fedelt01hub/honda-civic-scanner/hardware/fab/render-bottom.png

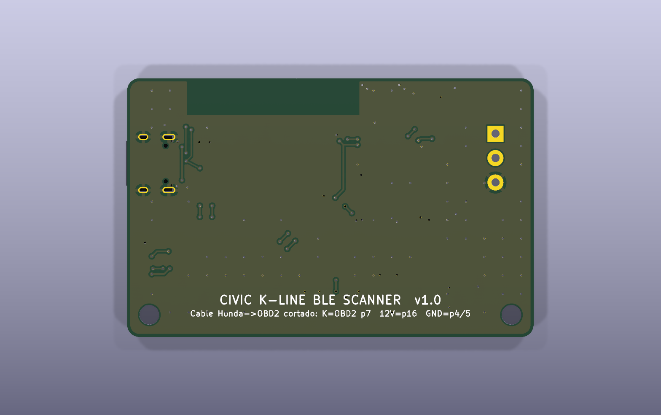
hardware/fab/render-bottom.png
