fedelt01hub/honda-civic-scanner/hardware/fab/render-top.png

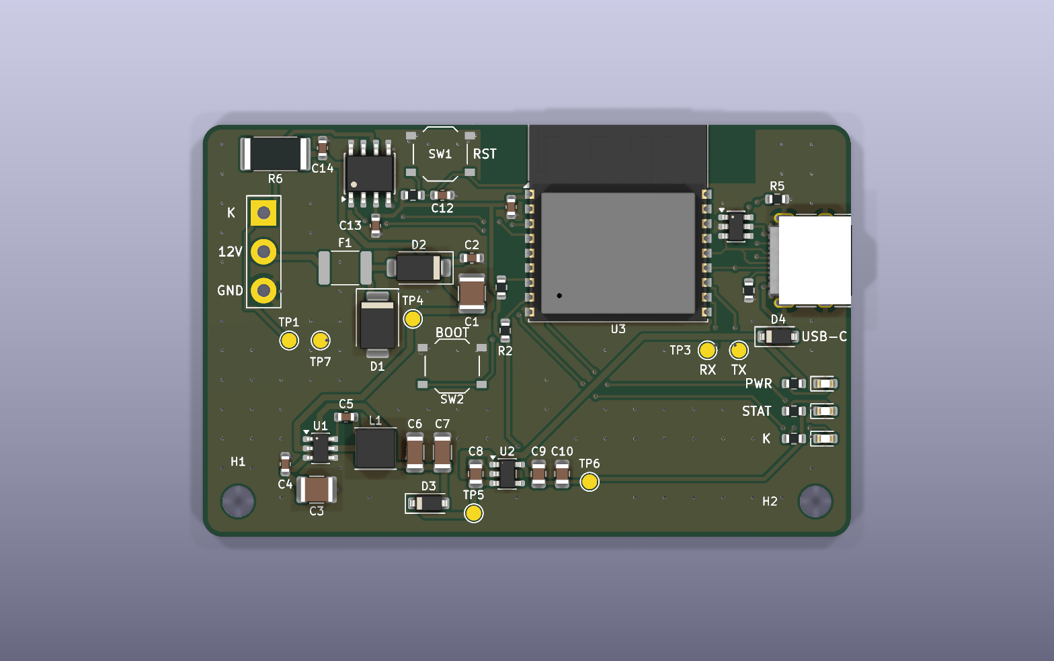
hardware/fab/render-top.png
