fedelt01hub/honda-civic-scanner/hardware/fab/civic_scanner-bom-jlcpcb.csv

Comment | Designator | Footprint | LCSC | Qty | MPN | Manufacturer
10uF 50V | C1,C3 | C_1210_3225Metric | C77102 | 2 | GRM32ER71H106KA12L | Murata
100nF 50V | C2,C4,C14 | C_0603_1608Metric | C14663 | 3 | CC0603KRX7R9BB104 | YAGEO
100nF | C5,C11,C13 | C_0603_1608Metric | C14663 | 3 | CC0603KRX7R9BB104 | YAGEO
22uF 25V | C6,C7 | C_1206_3216Metric | C12891 | 2 | CL31A226KAHNNNE | Samsung
10uF | C8,C9 | C_0805_2012Metric | C15850 | 2 | CL21A106KAYNNNE | Samsung
22uF | C10 | C_0805_2012Metric | C45783 | 1 | CL21A226MAQNNNE | Samsung
1uF | C12 | C_0603_1608Metric | C15849 | 1 | CL10A105KB8NNNC | Samsung
SMBJ18A | D1 | D_SMB | C353379 | 1 | SMBJ18A | Jingdao
SS34 | D2 | D_SMA | C8678 | 1 | SS34 | MDD
B5819W | D3,D4 | D_SOD-123 | C8598 | 2 | B5819W SL | Changjiang
PWR | D5 | LED_0603_1608Metric | C2290 | 1 | KT-0603W | Hubei KENTO
STATUS | D6 | LED_0603_1608Metric | C89811 | 1 | NCD0603Y2 | NATIONSTAR
K-LINE | D7 | LED_0603_1608Metric | C2286 | 1 | KT-0603R | Hubei KENTO
mSMD050-60V | F1 | Fuse_1812_4532Metric | C70113 | 1 | mSMD050-60V | Shenzhen JDT
USB-C | J2 | USB_C_Receptacle_HRO_TYPE-C-31-M-12 | C165948 | 1 | TYPE-C-31-M-12 | Korean Hroparts
4.7uH | L1 | L_Changjiang_FNR4030S | C167874 | 1 | FNR4030S4R7MT | Changjiang
10k | R1-R3 | R_0603_1608Metric | C25804 | 3 | 0603WAF1002T5E | UNI-ROYAL
5.1k | R4,R5 | R_0603_1608Metric | C23186 | 2 | 0603WAF5101T5E | UNI-ROYAL
1k 1W | R6 | R_2512_6332Metric | C54315 | 1 | 25121WF1001T4E | UNI-ROYAL
1k | R7-R9 | R_0603_1608Metric | C21190 | 3 | 0603WAF1001T5E | UNI-ROYAL
RESET | SW1 | SW_Push_1P1T_XKB_TS-1187A | C318884 | 1 | TS-1187A-B-A-B | XKB Connection
BOOT | SW2 | SW_Push_1P1T_XKB_TS-1187A | C318884 | 1 | TS-1187A-B-A-B | XKB Connection
AP63205WU-7 | U1 | TSOT-23-6 | C2071056 | 1 | AP63205WU-7 | Diodes Inc
AP2112K-3.3TRG1 | U2 | SOT-23-5 | C51118 | 1 | AP2112K-3.3TRG1 | Diodes Inc
ESP32-C3-WROOM-02-N4 | U3 | ESP32-C3-WROOM-02_JLC | C2934560 | 1 | ESP32-C3-WROOM-02-N4 | Espressif
USBLC6-2SC6 | U4 | SOT-23-6 | C2687116 | 1 | USBLC6-2SC6 | UMW
L9637D | U5 | SOIC-8_3.9x4.9mm_P1.27mm | C153038 | 1 | E-L9637D013TR | STMicroelectronics
