fedelt01hub/honda-civic-scanner/hardware/freecad/case_base_asm.stl

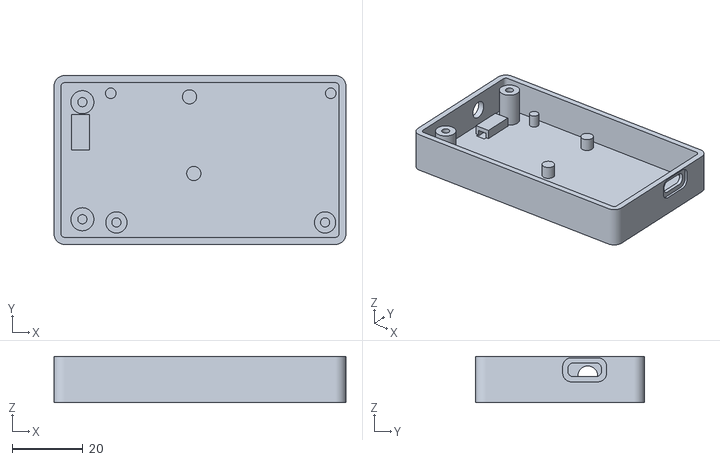
[picture p3: CAD file, 2026-11-05]
hardware/freecad/case_base_asm.stl
82.3 x 47.6 x 13.0
