fedelt01hub/honda-civic-scanner/hardware/enclosure/case_assembly.stl

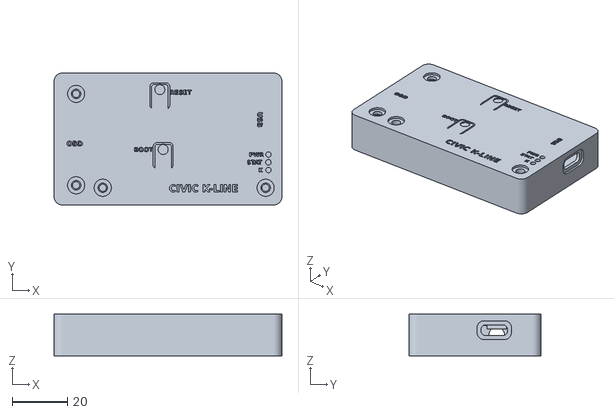
[picture p4: CAD file, 2026-11-05]
hardware/enclosure/case_assembly.stl
82.3 x 47.6 x 15.0
