fedelt01hub/honda-civic-scanner/hardware/freecad/case_lid_asm.stl

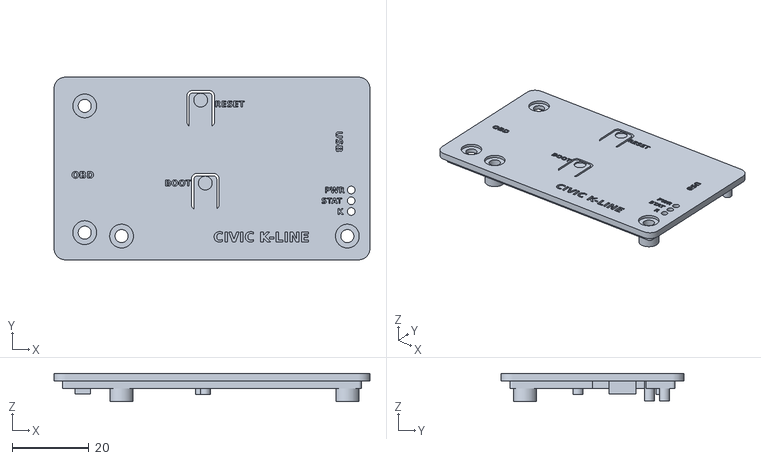
[picture p5: CAD file, 2026-11-05]
hardware/freecad/case_lid_asm.stl
82.3 x 47.6 x 7.35
