fedelt01hub/honda-civic-scanner/hardware/freecad/civic_scanner_ensamble.FCStd

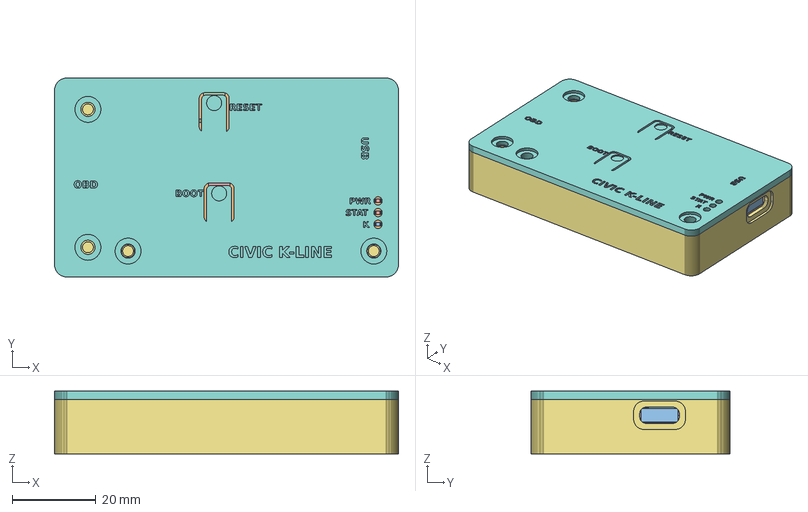
[picture p6: CAD file, 2026-11-05]
hardware/freecad/civic_scanner_ensamble.FCStd
82.3 x 47.6 x 15.0 mm
R_0603_1608Metric
C_0603_1608Metric
R_0603_1608Metric002
SOT-23-5
C_0603_1608Metric002
C_0603_1608Metric004
C_0603_1608Metric006
C_1210_3225Metric
D_SOD-123
R_0603_1608Metric004
LED_0603_1608Metric
ESP32-C3-WROOM-02
ESP32-C3-WROOM-001
ESP32-C3-WROOM-002
ESP32-C3-WROOM-003
ESP32-C3-WROOM-004
ESP32-C3-WROOM-005
ESP32-C3-WROOM-006
ESP32-C3-WROOM-007
ESP32-C3-WROOM-008
ESP32-C3-WROOM-009
ESP32-C3-WROOM-010
ESP32-C3-WROOM-011
ESP32-C3-WROOM-012
ESP32-C3-WROOM-013
ESP32-C3-WROOM-014
ESP32-C3-WROOM-015
ESP32-C3-WROOM-016
ESP32-C3-WROOM-017
ESP32-C3-WROOM-018
ESP32-C3-WROOM-019
ESP32-C3-WROOM-020
ESP32-C3-WROOM-021
ESP32-C3-WROOM-022
ESP32-C3-WROOM-023
ESP32-C3-WROOM-024
ESP32-C3-WROOM-025
ESP32-C3-WROOM-026
ESP32-C3-WROOM-027
ESP32-C3-WROOM-028
ESP32-C3-WROOM-029
SOIC-8_3.9x4.9mm_P1.27mm
R_0603_1608Metric006
C_1206_3216Metric
LED_0603_1608Metric002
R_2512_6332Metric
R_0603_1608Metric008
D_SMA
C_0805_2012Metric
R_0603_1608Metric010
C_0603_1608Metric008
TSOT-23-6
C_1210_3225Metric002
C_0805_2012Metric002
C_0603_1608Metric010
C_0805_2012Metric004
SOT-23-6
R_0603_1608Metric012
C_0603_1608Metric012
D_SOD-125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
