fedelt01hub/honda-civic-scanner/hardware/enclosure/case_preview_exploded.stl

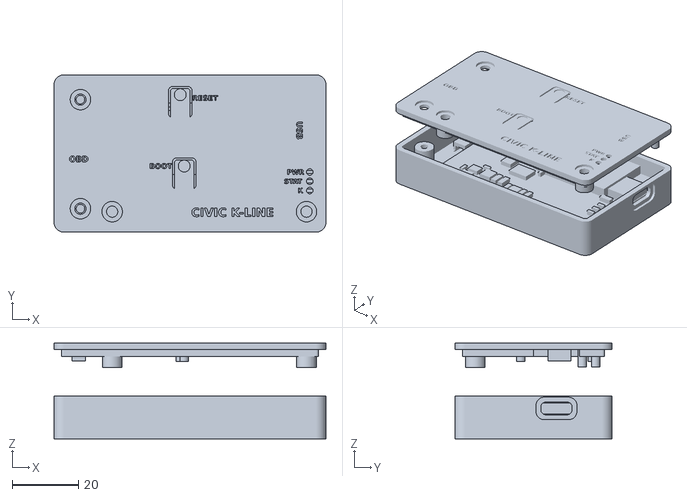
[picture p7: CAD file, 2026-11-05]
hardware/enclosure/case_preview_exploded.stl
82.3 x 47.6 x 29.0
