fedelt01hub/honda-civic-scanner/hardware/freecad/civic_scanner_pcb.step

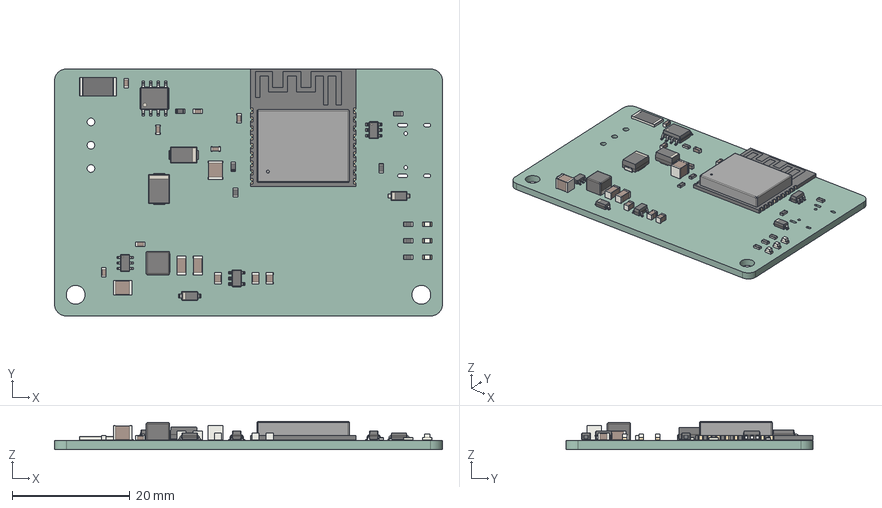
[picture p8: CAD file, 2026-11-05]
hardware/freecad/civic_scanner_pcb.step
66.0 x 42.0 x 4.79 mm
R_0603_1608Metric x 8
C_0603_1608Metric x 7
SOT-23-5
C_1210_3225Metric x 2
D_SOD-123 x 2
LED_0603_1608Metric x 3
ESP32-C3-WROOM-02
SOIC-8_3.9x4.9mm_P1.27mm
C_1206_3216Metric x 2
R_2512_6332Metric
D_SMA
C_0805_2012Metric x 3
TSOT-23-6
SOT-23-6
D_SMB
L_Changjiang_FNR4030S
civic_scanner_PCB
