fedelt01hub/honda-civic-scanner/(list of files, cad)

Other CAD files:
hardware/enclosure/case_base.stl
hardware/enclosure/case_lid.stl
