fedelt01hub/honda-civic-scanner/hardware/fab/civic_scanner-schematic.pdf

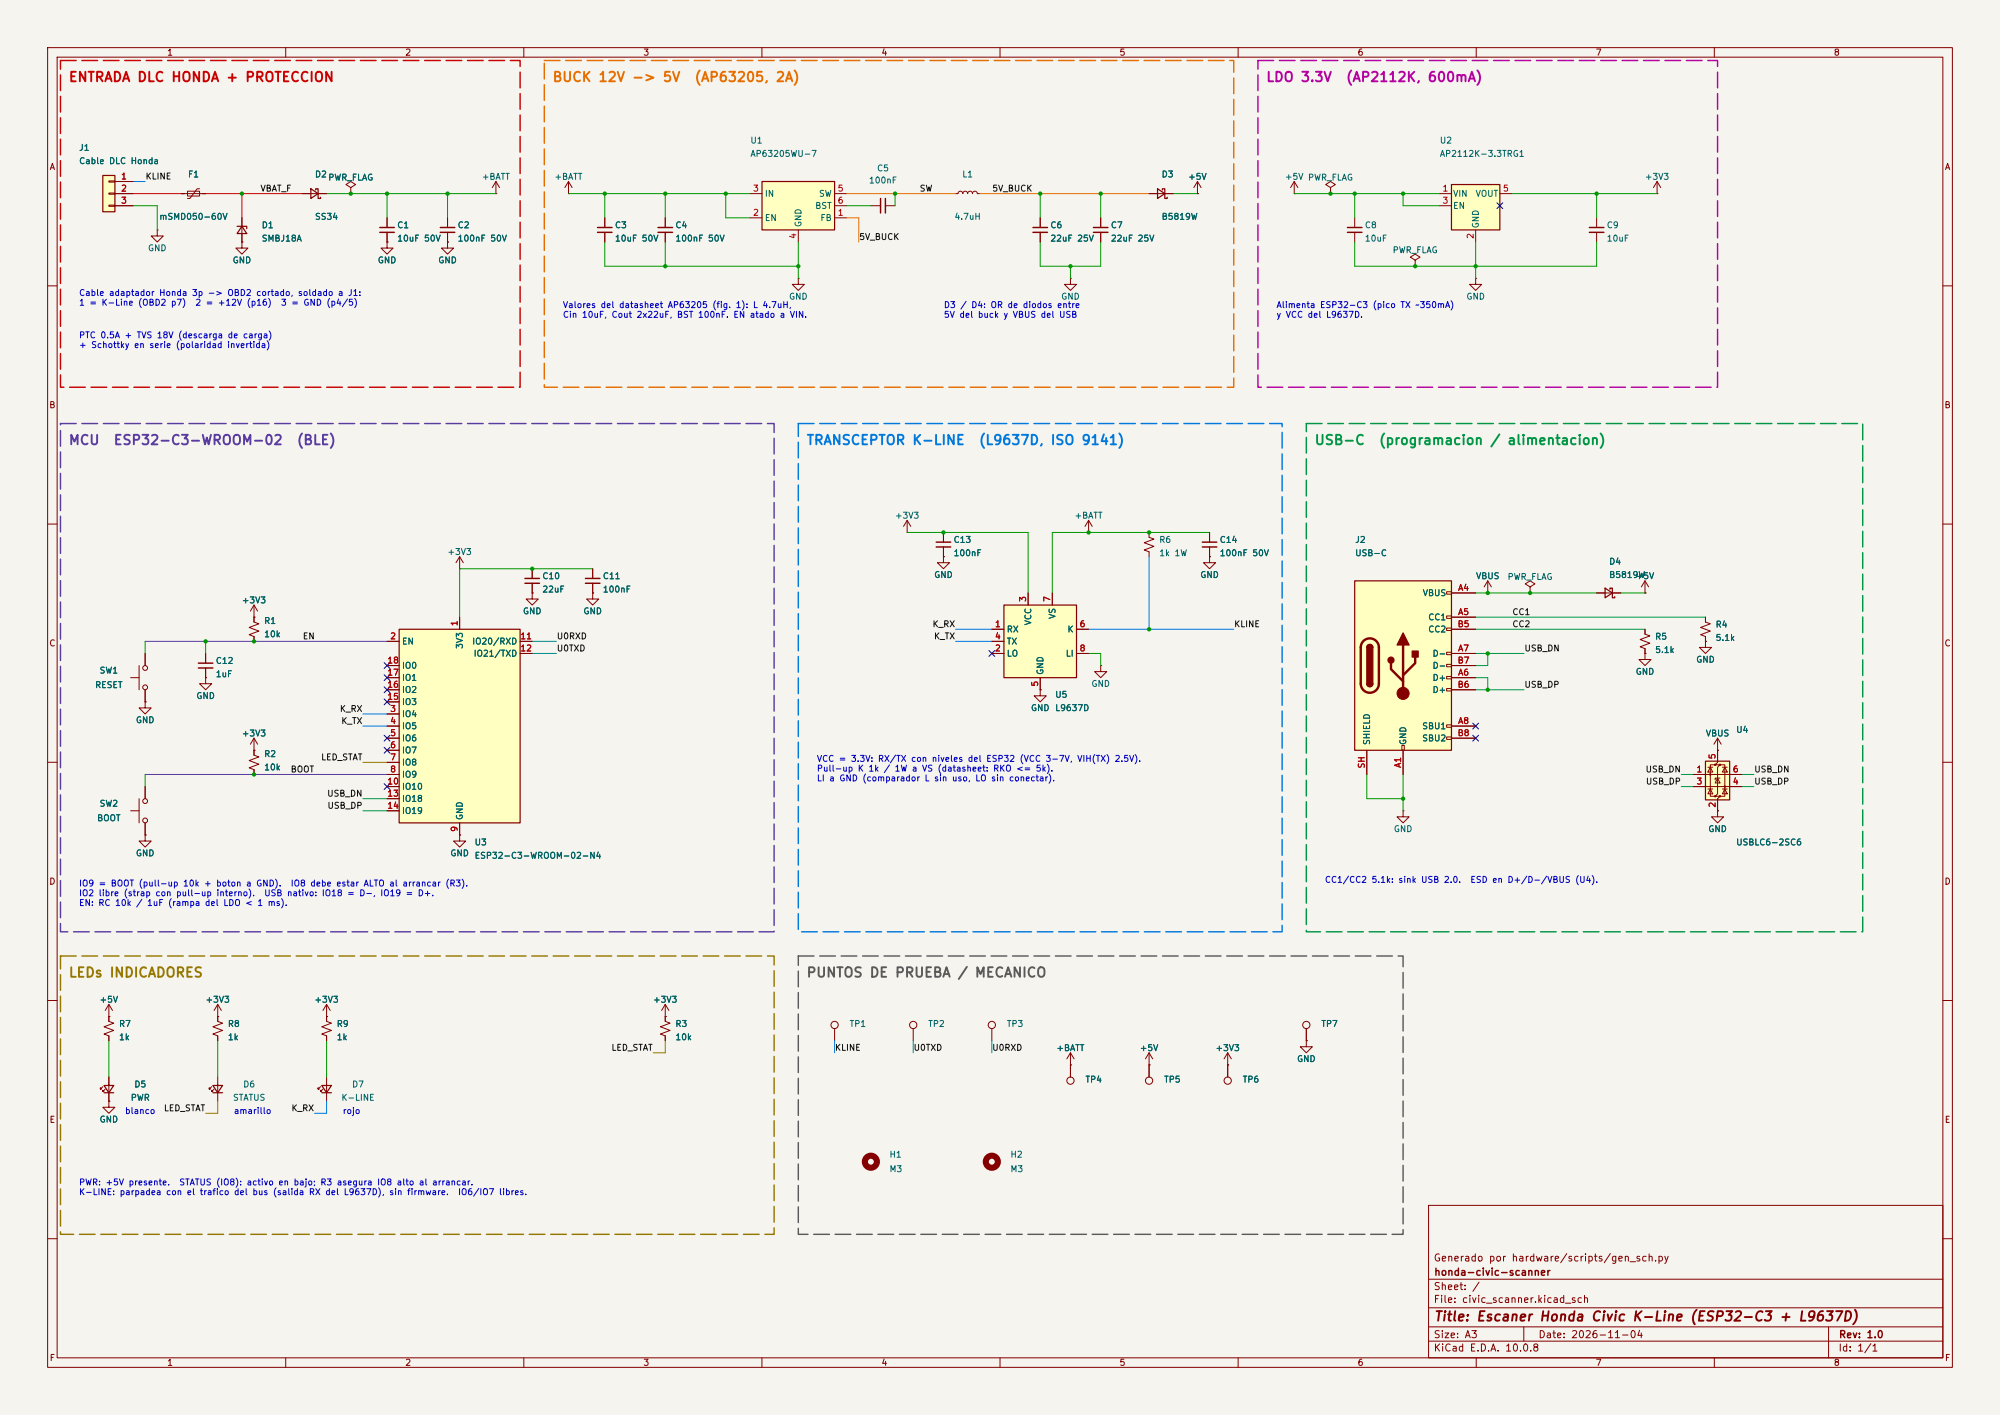
[picture p9: page 1]

ENTRADA DLC HONDA + PROTECCION

D3 / D4: OR de diodos entre 5V del buck y VBUS del USB PUNTOS DE PRUEBA / MECANICO

Cable adaptador Honda 3p -> OBD2 cortado, soldado a J1: 1 = K-Line (OBD2 p7) 2 = +12V (p16) 3 = GND (p4/5)

Alimenta ESP32-C3 (pico TX ~350mA) y VCC del L9637D.

PTC 0.5A + TVS 18V (descarga de carga) + Schottky en serie (polaridad invertida)

VCC = 3.3V: RX/TX con niveles del ESP32 (VCC 3-7V, VIH(TX) 2.5V).
Pull-up K 1k / 1W a VS (datasheet: RKO <= 5k). LI a GND (comparador L sin uso, LO sin conectar).

Generado por hardware/scripts/gen_sch.py
honda-civic-scanner
Sheet: /
File: civic_scanner.kicad_sch
Title: Escaner Honda Civic K-Line (ESP32-C3 + L9637D)

Size: A3 | Rev: 1.0 | F Date: 2026-11-04
KiCad E.D.A. 10.0.8 | Id: 1/1
