fedelt01hub/honda-civic-scanner/hardware/civic_scanner.kicad_pcb

## KiCad design hardware/civic_scanner.kicad_pcb (2026-11-05)

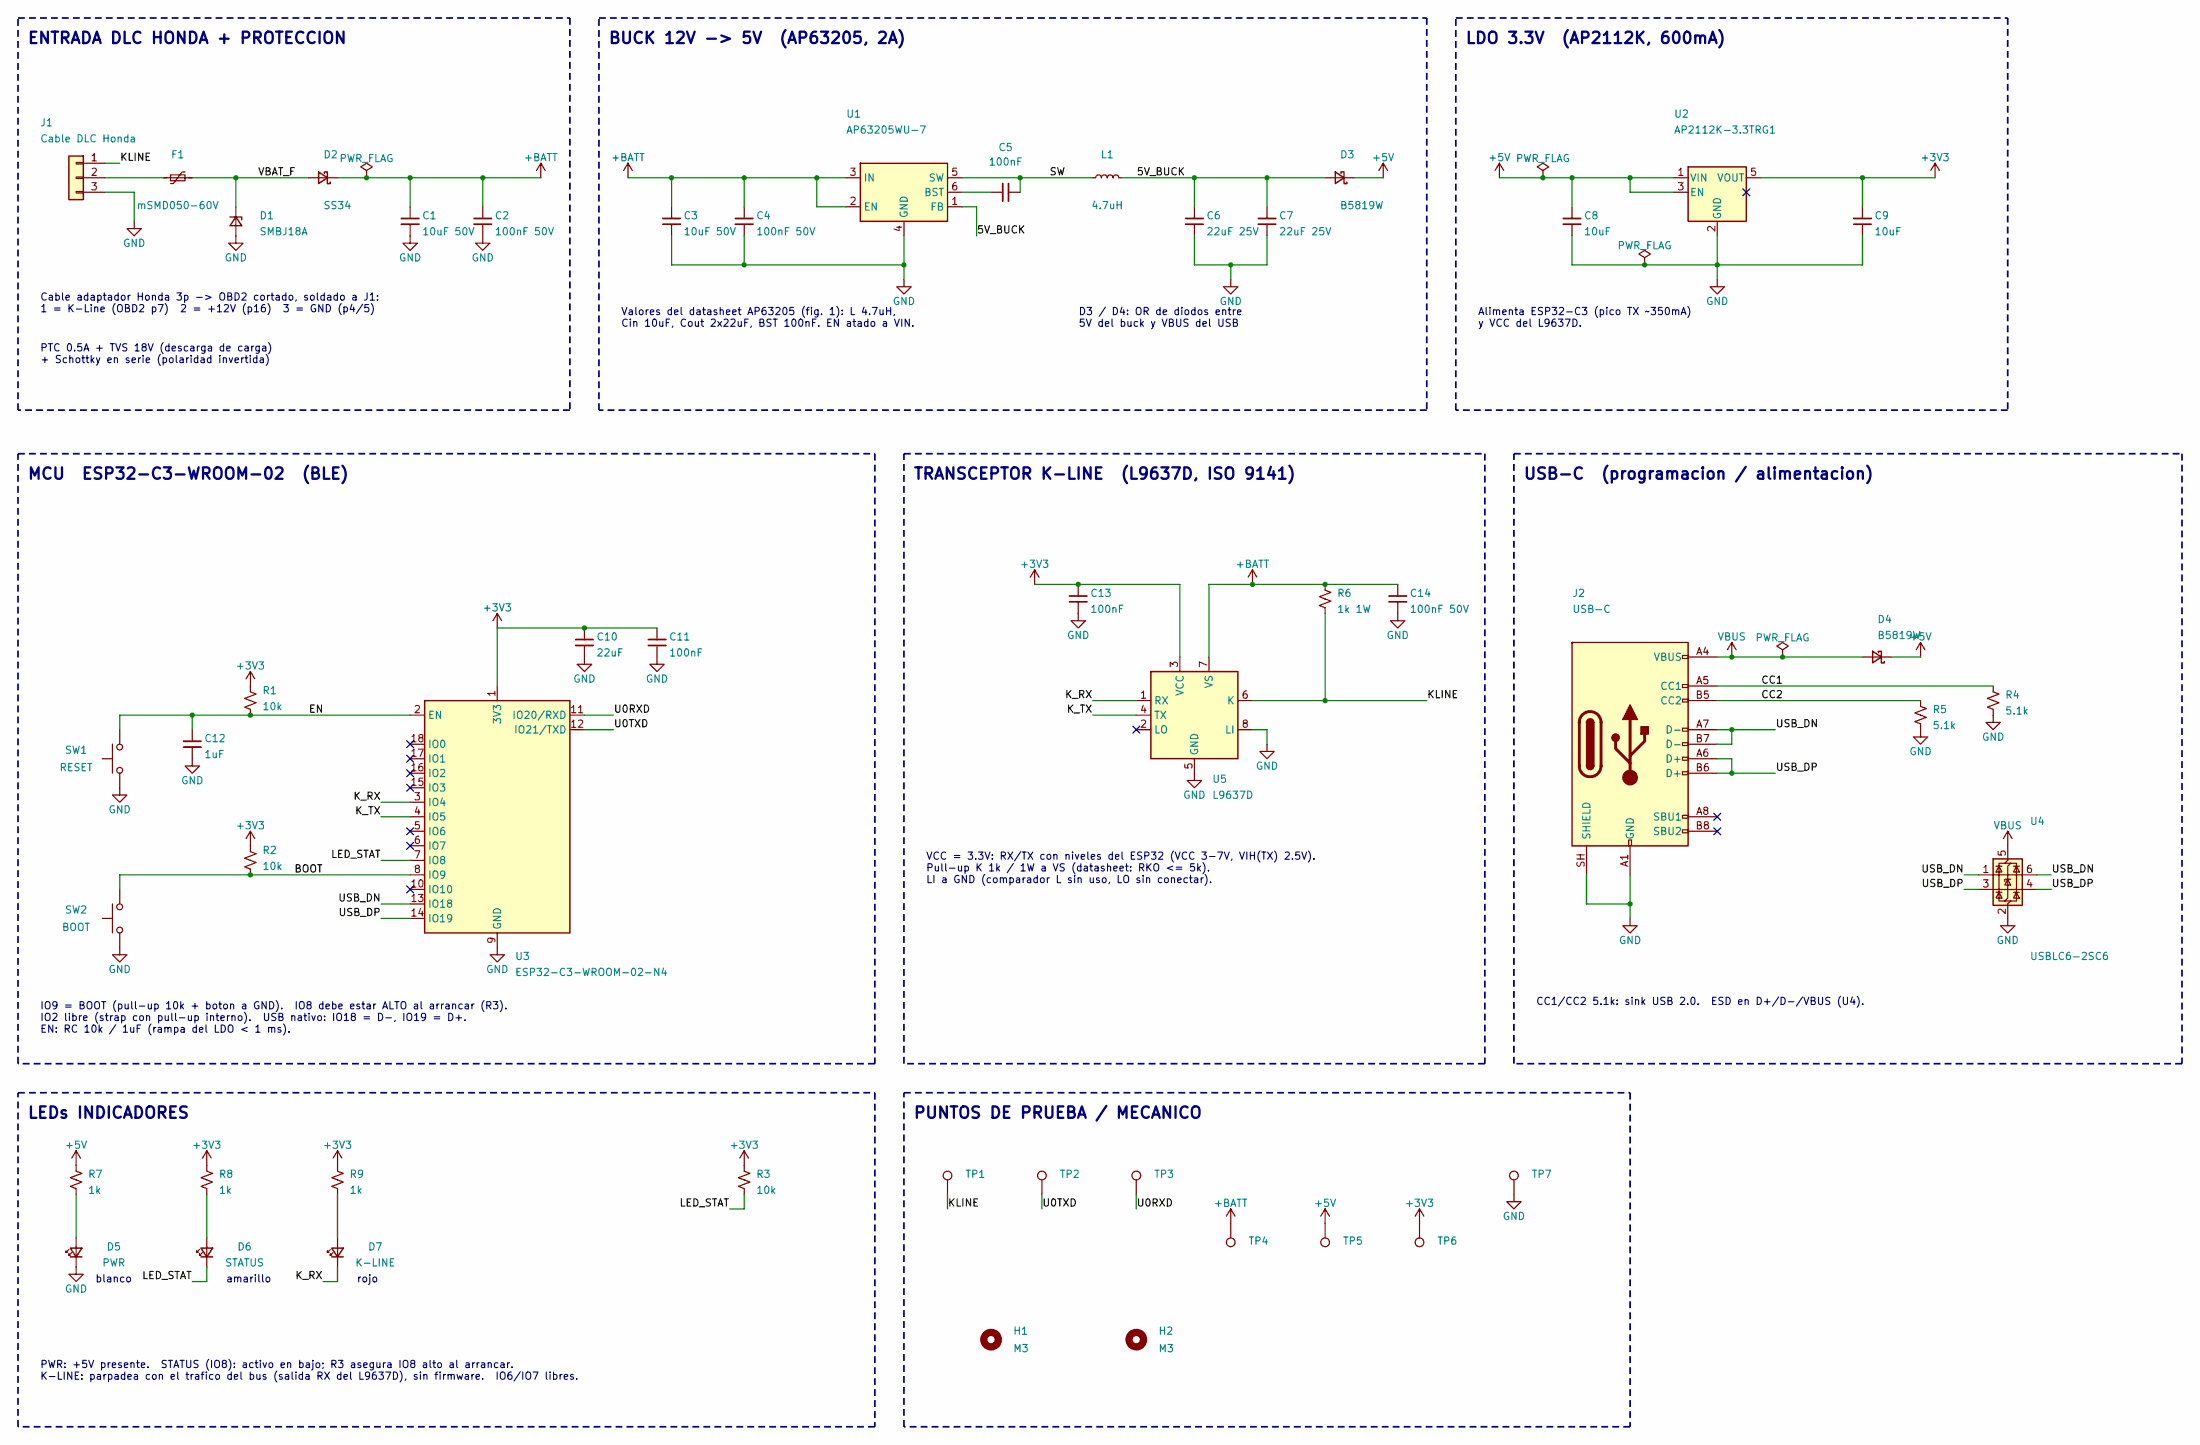
[picture p10: schematic civic_scanner.kicad_sch, Escaner Honda Civic K-Line (ESP32-C3 + L9637D)]

Parts:
C1, C3: 10uF 50V; C_1210_3225Metric; MPN GRM32ER71H106KA12L; LCSC C77102
C2, C4, C14: 100nF 50V; C_0603_1608Metric; MPN CC0603KRX7R9BB104; LCSC C14663
C5, C11, C13: 100nF; C_0603_1608Metric; MPN CC0603KRX7R9BB104; LCSC C14663
C6, C7: 22uF 25V; C_1206_3216Metric; MPN CL31A226KAHNNNE; LCSC C12891
C8, C9: 10uF; C_0805_2012Metric; MPN CL21A106KAYNNNE; LCSC C15850
C10: 22uF; C_0805_2012Metric; MPN CL21A226MAQNNNE; LCSC C45783
C12: 1uF; C_0603_1608Metric; MPN CL10A105KB8NNNC; LCSC C15849
D1: SMBJ18A; D_SMB; MPN SMBJ18A; LCSC C353379
D2: SS34; D_SMA; MPN SS34; LCSC C8678
D3, D4: B5819W; D_SOD-123; MPN B5819W SL; LCSC C8598
D5: PWR; LED_0603_1608Metric; MPN KT-0603W; LCSC C2290
D6: STATUS; LED_0603_1608Metric; MPN NCD0603Y2; LCSC C89811
D7: K-LINE; LED_0603_1608Metric; MPN KT-0603R; LCSC C2286
F1: mSMD050-60V; Fuse_1812_4532Metric; MPN mSMD050-60V; LCSC C70113
H1, H2: M3; MountingHole_3.2mm_M3
J1: Cable DLC Honda; Cable_Wire_1x03_P3.96mm
J2: USB-C; USB_C_Receptacle_HRO_TYPE-C-31-M-12; MPN TYPE-C-31-M-12; LCSC C165948
L1: 4.7uH; L_Changjiang_FNR4030S; MPN FNR4030S4R7MT; LCSC C167874
R1, R2, R3: 10k; R_0603_1608Metric; MPN 0603WAF1002T5E; LCSC C25804
R4, R5: 5.1k; R_0603_1608Metric; MPN 0603WAF5101T5E; LCSC C23186
R6: 1k 1W; R_2512_6332Metric; MPN 25121WF1001T4E; LCSC C54315
R7, R8, R9: 1k; R_0603_1608Metric; MPN 0603WAF1001T5E; LCSC C21190
SW1: RESET; SW_Push_1P1T_XKB_TS-1187A; MPN TS-1187A-B-A-B; LCSC C318884
SW2: BOOT; SW_Push_1P1T_XKB_TS-1187A; MPN TS-1187A-B-A-B; LCSC C318884
TP1: KLINE; TestPoint_Pad_D1.5mm
TP2: U0TXD; TestPoint_Pad_D1.5mm
TP3: U0RXD; TestPoint_Pad_D1.5mm
TP4: +BATT; TestPoint_Pad_D1.5mm
TP5: +5V; TestPoint_Pad_D1.5mm
TP6: +3V3; TestPoint_Pad_D1.5mm
TP7: GND; TestPoint_Pad_D1.5mm
U1: AP63205WU-7; TSOT-23-6; MPN AP63205WU-7; LCSC C2071056
U2: AP2112K-3.3TRG1; SOT-23-5; MPN AP2112K-3.3TRG1; LCSC C51118
U3: ESP32-C3-WROOM-02-N4; ESP32-C3-WROOM-02_JLC; MPN ESP32-C3-WROOM-02-N4; LCSC C2934560
U4: USBLC6-2SC6; SOT-23-6; MPN USBLC6-2SC6; LCSC C2687116
U5: L9637D; SOIC-8_3.9x4.9mm_P1.27mm; MPN E-L9637D013TR; LCSC C153038

Connections:
+3V3: C9.1, C10.1, C11.1, C13.1, R1.1, R2.1, R3.1, R8.1, R9.1, TP6.1, U2.5 (VOUT), U3.1 (3V3), U5.3 (VCC)
+5V: C8.1, D3.1 (K), D4.1 (K), R7.1, TP5.1, U2.1 (VIN), U2.3 (EN)
+BATT: C1.1, C2.1, C3.1, C4.1, C14.1, D2.1 (K), R6.1, TP4.1, U1.2 (EN), U1.3 (IN), U5.7 (VS)
/5V_BUCK: C6.1, C7.1, D3.2 (A), L1.2, U1.1 (FB)
/BOOT: R2.2, SW2.2, U3.8 (IO9)
/CC1: J2.A5 (CC1), R4.1
/CC2: J2.B5 (CC2), R5.1
/EN: C12.1, R1.2, SW1.2, U3.2 (EN)
/KLINE: J1.1, R6.2, TP1.1, U5.6 (K)
/K_RX: D7.1 (K), U3.3 (IO4), U5.1 (RX)
/K_TX: U3.4 (IO5), U5.4 (TX)
/LED_STAT: D6.1 (K), R3.2, U3.7 (IO8)
/SW: C5.2, L1.1, U1.5 (SW)
/U0RXD: TP3.1, U3.11 (IO20/RXD)
/U0TXD: TP2.1, U3.12 (IO21/TXD)
/USB_DN: J2.A7 (D-), J2.B7 (D-), U3.13 (IO18), U4.1 (I/O1), U4.6 (I/O1)
/USB_DP: J2.A6 (D+), J2.B6 (D+), U3.14 (IO19), U4.3 (I/O2), U4.4 (I/O2)
/VBAT_F: D1.1 (K), D2.2 (A), F1.2
GND: C1.2, C2.2, C3.2, C4.2, C6.2, C7.2, C8.2, C9.2, C10.2, C11.2, C12.2, C13.2, C14.2, D1.2 (A), D5.1 (K), J1.3, J2.A1 (GND), J2.A12 (GND), J2.B1 (GND), J2.B12 (GND), J2.SH (SHIELD), R4.2, R5.2, SW1.1, SW2.1, TP7.1, U1.4 (GND), U2.2 (GND), U3.9 (GND), U3.19 (GND), U4.2 (GND), U5.5 (GND), U5.8 (LI)
unnamed: D5.2 (A), R7.2
unnamed: D6.2 (A), R8.2
unnamed: D7.2 (A), R9.2
unnamed: F1.1, J1.2
unnamed: C5.1, U1.6 (BST)
VBUS: D4.2 (A), J2.A4 (VBUS), J2.A9 (VBUS), J2.B4 (VBUS), J2.B9 (VBUS), U4.5 (VBUS)

Notes on the sheet:
ENTRADA DLC HONDA + PROTECCION
Cable adaptador Honda 3p -> OBD2 cortado, soldado a J1: 1 = K-Line (OBD2 p7) 2 = +12V (p16) 3 = GND (p4/5)
PTC 0.5A + TVS 18V (descarga de carga) + Schottky en serie (polaridad invertida)
BUCK 12V -> 5V (AP63205, 2A)
Valores del datasheet AP63205 (fig. 1): L 4.7uH, Cin 10uF, Cout 2x22uF, BST 100nF. EN atado a VIN.
D3 / D4: OR de diodos entre 5V del buck y VBUS del USB
LDO 3.3V (AP2112K, 600mA)
Alimenta ESP32-C3 (pico TX ~350mA) y VCC del L9637D.
USB-C (programacion / alimentacion)
CC1/CC2 5.1k: sink USB 2.0. ESD en D+/D-/VBUS (U4).
MCU ESP32-C3-WROOM-02 (BLE)
IO9 = BOOT (pull-up 10k + boton a GND). IO8 debe estar ALTO al arrancar (R3). IO2 libre (strap con pull-up interno). USB nativo: IO18 = D-, IO19 = D+. EN: RC 10k / 1uF (rampa del LDO < 1 ms).
TRANSCEPTOR K-LINE (L9637D, ISO 9141)
VCC = 3.3V: RX/TX con niveles del ESP32 (VCC 3-7V, VIH(TX) 2.5V). Pull-up K 1k / 1W a VS (datasheet: RKO <= 5k). LI a GND (comparador L sin uso, LO sin conectar).
LEDs INDICADORES
blanco
amarillo
rojo
PWR: +5V presente. STATUS (IO8): activo en bajo; R3 asegura IO8 alto al arrancar. K-LINE: parpadea con el trafico del bus (salida RX del L9637D), sin firmware. IO6/IO7 libres.
PUNTOS DE PRUEBA / MECANICO

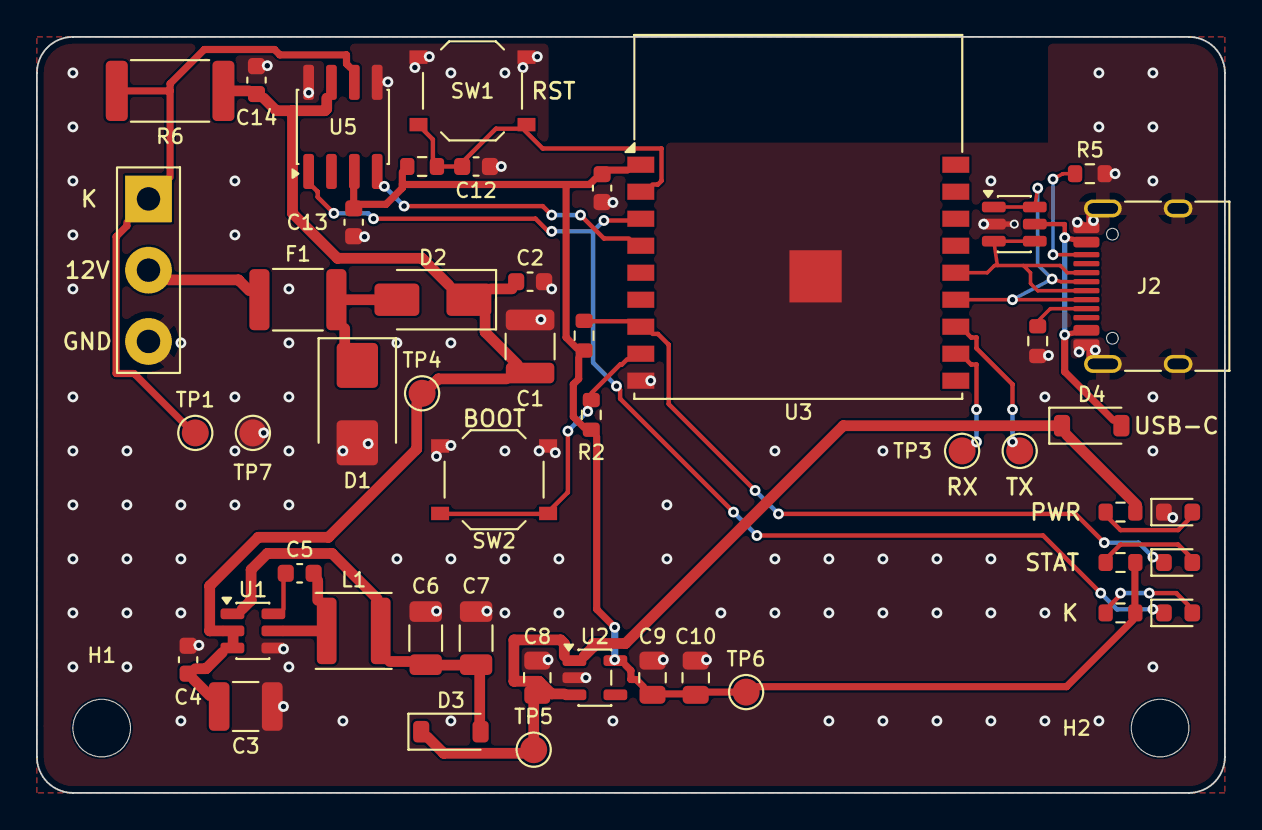
[picture p11: board civic_scanner.kicad_pcb from above]

Board: 2 copper layers, 66.0 x 42.0 mm, 50 parts (0 on the bottom side), 25 nets.
