fedelt01hub/honda-civic-scanner/honda-civic-scanner.ino

/*
 * ==============================================================================
 * K-Lino - Escáner PGM-FI y telemetría BLE (compatible con Honda Civic 96-00, DLC 3 pines)
 * ==============================================================================
 * Plataforma: ESP32-C3 (BLE 5.0)
 * Transceptor: L9637D (ISO 9141 / K-Line)
 * Protocolo: Honda 3-Pin DLC (9600 Baud, 8N1, Half-Duplex, 20 05 ADDR LEN CS)
 *
 * Anuncia el servicio estándar Nordic UART Service (NUS) como 'K-Lino-XXXX'
 * y transmite telemetría en tiempo real a 20 Hz (paquetes binarios de 29 bytes)
 * hacia la aplicación móvil PWA / Web Bluetooth.
 * ==============================================================================
 */

#include "honda_kline.h"
#include "telemetry_frame.h"
#include "device_info.h"
#include "power_policy.h"
#include <esp_mac.h>
#include <esp_sleep.h>
#include <BLEDevice.h>
#include <BLEServer.h>
#include <BLEUtils.h>

// ==============================================================================
// COLA DE COMANDOS K-LINE (ACCESO EXCLUSIVO DESDE EL LOOP)
// ==============================================================================
enum PendingCmd : uint8_t {
  CMD_NONE,
  CMD_GET_DTC,
  CMD_CLEAR_DTC,
  CMD_ECHO,
  CMD_REINIT,
  CMD_GET_DIAG
};
volatile PendingCmd pendingCmd = CMD_NONE;

// ==============================================================================
// CONFIGURACIÓN DE PINES
// ==============================================================================
#define KLINE_RX_PIN 4
#define KLINE_TX_PIN 5
#define LED_STATUS_PIN 8

// ==============================================================================
// CONFIGURACIÓN BLUETOOTH LOW ENERGY (NORDIC UART SERVICE)
// ==============================================================================
#define BLE_DEVICE_NAME "K-Lino"   // prefijo; el nombre real lleva "-XXXX" de la MAC
static char bleName[24] = BLE_DEVICE_NAME;
#define SERVICE_UUID           "6E400001-B5A3-F393-E0A9-E50E24DCCA9E"
#define CHARACTERISTIC_UUID_RX "6E400002-B5A3-F393-E0A9-E50E24DCCA9E"
#define CHARACTERISTIC_UUID_TX "6E400003-B5A3-F393-E0A9-E50E24DCCA9E"

BLEServer *pServer = nullptr;
BLECharacteristic *pTxCharacteristic = nullptr;
BLECharacteristic *pRxCharacteristic = nullptr;

bool deviceConnected = false;
bool oldDeviceConnected = false;
unsigned long lastBleNotify = 0;

// Ahorro de energía (ver power_policy.h)
uint32_t lastActivityMs = 0;
uint32_t awakeWindowMs = AWAKE_WINDOW_COLD_BOOT_MS;

// Enviar cadena de texto / JSON por la característica TX
void bleSendText(const String &str) {
  if (!deviceConnected || !pTxCharacteristic) return;
  String full = str.endsWith("\n") ? str : (str + "\n");
  size_t len = full.length();
  const uint8_t *data = (const uint8_t *)full.c_str();
  // Bloques de máximo 128 bytes y nunca más que MTU-3 (el stack BLE trunca el resto)
  uint16_t mtu = pServer ? pServer->getPeerMTU(pServer->getConnId()) : 23;
  size_t maxChunk = (mtu > 23) ? (size_t)(mtu - 3) : 20;
  if (maxChunk > 128) maxChunk = 128;
  size_t offset = 0;
  while (offset < len) {
    size_t chunk = len - offset;
    if (chunk > maxChunk) chunk = maxChunk;
    pTxCharacteristic->setValue((uint8_t *)(data + offset), chunk);
    pTxCharacteristic->notify();
    offset += chunk;
    delay(15);
  }
}

// Callbacks del Servidor BLE (Conexión / Desconexión)
class ServerCallbacks : public BLEServerCallbacks {
  void onConnect(BLEServer *pServer) override {
    deviceConnected = true;
    Serial.println("[BLE] ¡Dispositivo móvil conectado!");
  }

  void onDisconnect(BLEServer *pServer) override {
    deviceConnected = false;
    Serial.println("[BLE] Dispositivo móvil desconectado.");
  }
};

void handlePendingCmd(PendingCmd cmd) {
  switch (cmd) {
    case CMD_GET_DTC: {
      std::vector<DtcCode> codes;
      bool ok = honda.getActiveDTCs(codes);
      if (ok) {
        String json = "{\"type\":\"dtc\",\"ok\":true,\"mil\":" + String(honda.data.mil ? "true" : "false");
        if (honda.diag.freezeFrame.valid) {
          char ffBuf[256];
          const FreezeFrame &ff = honda.diag.freezeFrame;
          snprintf(ffBuf, sizeof(ffBuf),
                   ",\"freezeFrame\":{\"rpm\":%d,\"vss\":%d,\"ect\":%d,\"iat\":%d,\"map\":%d,\"baro\":%d,\"tps\":%d,"
                   "\"rawHex\":\"%02X %02X %02X %02X %02X %02X %02X %02X\"}",
                   ff.rpm, ff.vss, ff.ect, ff.iat, ff.map, ff.baro, ff.tps,
                   ff.rawVss, ff.rawRpmHi, ff.rawRpmLo, ff.rawEct, ff.rawIat, ff.rawMap, ff.rawBaro, ff.rawTps);
          json += ffBuf;
        }
        json += ",\"codes\":[";
        for (size_t i = 0; i < codes.size(); i++) {
          json += "{\"code\":" + String(codes[i].code) + ",";
          json += "\"name\":\"" + String(codes[i].name) + "\",";
          json += "\"desc\":\"" + String(codes[i].desc) + "\"}";
          if (i + 1 < codes.size()) json += ",";
        }
        json += "]}";
        bleSendText(json);
      } else {
        char errBuf[128];
        snprintf(errBuf, sizeof(errBuf), "{\"type\":\"dtc\",\"ok\":false,\"error\":\"%s\"}", honda.diag.lastError);
        bleSendText(errBuf);
      }
      lastBleNotify = millis(); // Evita que la trama binaria salga pegada al JSON
      break;
    }
    case CMD_CLEAR_DTC: {
      ClearDtcResult r;
      honda.clearAndVerify(r);
      char clearBuf[160];
      formatClearDtcJson(r, clearBuf, sizeof(clearBuf));
      bleSendText(clearBuf);
      lastBleNotify = millis();
      break;
    }
    case CMD_ECHO: {
      honda.echoTest(16);
      char buf[128];
      snprintf(buf, sizeof(buf),
               "{\"type\":\"echo\",\"sent\":%d,\"rx\":%d,\"ok\":%d}",
               honda.diag.echoTestSent, honda.diag.echoTestRx, honda.diag.echoTestOk);
      bleSendText(buf);
      break;
    }
    case CMD_REINIT: {
      bool ok = honda.sendInit();
      bleSendText(String("{\"type\":\"reinit\",\"success\":") + (ok ? "true}" : "false}"));
      break;
    }
    case CMD_GET_DIAG: {
      const DiagInfo &g = honda.diag;
      char diagBuf[850];
      snprintf(diagBuf, sizeof(diagBuf),
               "{\"type\":\"diag\",\"state\":\"%s\",\"connected\":%s,\"mil\":%s,"
               "\"cmdSent\":%d,\"cmdOk\":%d,\"cmdTimeout\":%d,\"cmdCrcFail\":%d,"
               "\"rxBytes\":%d,\"echoOk\":%d,\"echoFail\":%d,\"ecuType\":%d,"
               "\"uptime\":%lu,\"row0\":\"%s\",\"row1\":\"%s\",\"row2\":\"%s\",\"row3\":\"%s\","
               "\"dtc0\":\"%s\",\"dtc1\":\"%s\",\"dtc2\":\"%s\",\"rawEld\":%d,\"rawO2Sec\":%d,"
               "\"d8\":%d,\"d10\":%d,\"d11\":%d}",
               honda.stateName(), honda.data.connected ? "true" : "false", honda.data.mil ? "true" : "false",
               g.cmdSent, g.cmdOk, g.cmdTimeout, g.cmdCrcFail,
               g.rxBytes, g.echoOk, g.echoFail, honda.ecuType,
               millis() / 1000,
               g.row0Hex, g.row1Hex, g.row2Hex, g.row3Hex,
               g.dtcRawHex[0], g.dtcRawHex[1], g.dtcRawHex[2], g.rawEldByte, g.rawO2SecByte,
               g.d8Byte, g.d10Byte, g.d11Byte);
      bleSendText(diagBuf);
      lastBleNotify = millis(); // Evita que la trama binaria salga pegada al JSON
      break;
    }
    default:
      break;
  }
}

// Callbacks de Comandos entrantes desde la App móvil (RX)
class RxCallbacks : public BLECharacteristicCallbacks {
  void onWrite(BLECharacteristic *pCharacteristic) override {
    String rxValue = pCharacteristic->getValue();
    if (rxValue.length() == 0) return;

    rxValue.trim();
    Serial.printf("[BLE-RX] Comando recibido: '%s'\n", rxValue.c_str());

    // 1. Alternar tipo de ECU (1 = OBD1, 2 = OBD2)
    if (rxValue.startsWith("ECU:")) {
      int t = rxValue.substring(4).toInt();
      if (t == 1 || t == 2) {
        honda.ecuType = t;
        bleSendText("{\"type\":\"ecuType\",\"val\":" + String(t) + "}");
      }
    }
    // Identificación del equipo: versión de firmware/hardware y nombre BLE
    else if (rxValue == "INFO") {
      char buf[160];
      formatInfoJson(FW_VERSION, HW_REV, bleName, honda.ecuType, buf, sizeof(buf));
      bleSendText(buf);
    }
    // 2. Alternar modo Demo
    else if (rxValue.startsWith("DEMO:")) {
      bool en = (rxValue.substring(5).toInt() == 1);
      honda.setDemoMode(en);
      bleSendText(String("{\"type\":\"demo\",\"val\":") + (en ? "true}" : "false}"));
    }
    // 3. Solicitar Códigos DTC (se encola para ejecución exclusiva en loop)
    else if (rxValue == "GET_DTC") {
      pendingCmd = CMD_GET_DTC;
    }
    // 4. Borrar códigos DTC (se encola para ejecución exclusiva en loop)
    else if (rxValue == "CLEAR_DTC") {
      pendingCmd = CMD_CLEAR_DTC;
    }
    // 5. Solicitar estadísticas de diagnóstico (se encola solo si no hay comando prioritario)
    else if (rxValue == "GET_DIAG") {
      if (pendingCmd == CMD_NONE) {
        pendingCmd = CMD_GET_DIAG;
      }
    }
    // 6. Prueba de eco de hardware (se encola)
    else if (rxValue == "ECHO") {
      pendingCmd = CMD_ECHO;
    }
    // 7. Reiniciar contadores
    else if (rxValue == "RESET_COUNTERS") {
      honda.resetCounters();
      bleSendText("{\"type\":\"resetCounters\",\"success\":true}");
    }
    // 8. Reintentar inicialización K-Line (se encola)
    else if (rxValue == "REINIT") {
      pendingCmd = CMD_REINIT;
    }
  }
};

void setup() {
  Serial.begin(115200);
  delay(500);
  Serial.println("\n--- K-Lino Scanner BLE Inicializando ---");

  // Si venimos de deep sleep (llave en OFF), solo una ventana corta para buscar la ECU
  if (esp_sleep_get_wakeup_cause() == ESP_SLEEP_WAKEUP_TIMER) {
    awakeWindowMs = AWAKE_WINDOW_AFTER_WAKE_MS;
  }

  // Configurar LED de estado
  pinMode(LED_STATUS_PIN, OUTPUT);
  digitalWrite(LED_STATUS_PIN, LOW);

  // Inicializar driver K-Line Honda
  Serial.println("[K-LINE] Configurando UART a 9600 baudios...");
  honda.begin(KLINE_RX_PIN, KLINE_TX_PIN);

  // Configurar e inicializar BLE
  uint8_t mac[6];
  esp_read_mac(mac, ESP_MAC_BT);
  formatDeviceName(BLE_DEVICE_NAME, mac, bleName, sizeof(bleName));
  Serial.printf("[BLE] Inicializando dispositivo BLE '%s' FW %s HW %s...\n", bleName, FW_VERSION, HW_REV);
  BLEDevice::init(bleName);

  // Crear Servidor BLE
  pServer = BLEDevice::createServer();
  pServer->setCallbacks(new ServerCallbacks());

  // Crear Servicio Nordic UART
  BLEService *pService = pServer->createService(SERVICE_UUID);

  // Característica TX (Notificación hacia el celular)
  pTxCharacteristic = pService->createCharacteristic(
      CHARACTERISTIC_UUID_TX,
      BLECharacteristic::PROPERTY_NOTIFY
  );

  // Característica RX (Escritura desde el celular)
  pRxCharacteristic = pService->createCharacteristic(
      CHARACTERISTIC_UUID_RX,
      BLECharacteristic::PROPERTY_WRITE | BLECharacteristic::PROPERTY_WRITE_NR
  );
  pRxCharacteristic->setCallbacks(new RxCallbacks());

  // Iniciar servicio y anuncio (Advertising)
  pService->start();
  BLEAdvertising *pAdvertising = BLEDevice::getAdvertising();
  pAdvertising->addServiceUUID(SERVICE_UUID);
  pAdvertising->setScanResponse(true);
  pAdvertising->setMinPreferred(0x06); // Funciones de baja latencia en iOS/Android
  pAdvertising->setMinPreferred(0x12);
  BLEDevice::startAdvertising();

  Serial.println("[BLE] Servicio Nordic UART activo y anunciando.");

  // Enviar secuencia inicial de detección de ECU
  honda.sendInit();
}

// Empaquetar y notificar la trama binaria de telemetría (formato en telemetry_frame.h)
void sendTelemetryFrame() {
  if (!deviceConnected || !pTxCharacteristic) return;
  uint8_t frame[TELEMETRY_FRAME_LEN];
  packTelemetryFrame(honda.data, frame);
  pTxCharacteristic->setValue(frame, sizeof(frame));
  pTxCharacteristic->notify();
}

void loop() {
  // Procesar comandos pesados pendientes (DTC, eco, reinit) con acceso exclusivo al UART K-Line
  if (pendingCmd != CMD_NONE) {
    PendingCmd c = pendingCmd;
    pendingCmd = CMD_NONE;
    handlePendingCmd(c);
  } else {
    // Actualizar lectura continua de la ECU Honda
    honda.update();
  }

  // Gestión de reconexión BLE
  if (!deviceConnected && oldDeviceConnected) {
    delay(100); // Pequeña pausa para que la pila BLE limpie buffers
    pServer->startAdvertising();
    Serial.println("[BLE] Reiniciando publicidad...");
    oldDeviceConnected = deviceConnected;
  }
  if (deviceConnected && !oldDeviceConnected) {
    oldDeviceConnected = deviceConnected;
  }

  // Notificar telemetría por BLE cada 50ms (20 Hz)
  unsigned long now = millis();
  if (deviceConnected && (now - lastBleNotify >= 50)) {
    lastBleNotify = now;
    sendTelemetryFrame();
  }

  // Parpadeo de LED de estado:
  // - Rápido (200ms) si no hay conexión BLE ni de ECU
  // - Pulsos suaves (1000ms) cuando todo está sincronizado
  static unsigned long lastBlink = 0;
  unsigned long blinkInterval = (deviceConnected && honda.data.connected) ? 1000 : 250;
  if (now - lastBlink > blinkInterval) {
    lastBlink = now;
    digitalWrite(LED_STATUS_PIN, !digitalRead(LED_STATUS_PIN));
  }

  // Ahorro de energía: sin celular ni ECU (llave en OFF) -> deep sleep por timer
  bool ecuActive = honda.data.connected || honda.data.demo;
  if (deviceConnected || ecuActive) {
    lastActivityMs = now;
    awakeWindowMs = AWAKE_WINDOW_COLD_BOOT_MS; // tras actividad real, volver a la ventana larga
  }
  if (shouldDeepSleep(now, lastActivityMs, deviceConnected, ecuActive, awakeWindowMs)) {
    Serial.println("[PWR] Sin ECU ni celular: deep sleep");
    Serial.flush();
    digitalWrite(LED_STATUS_PIN, LOW);
    esp_sleep_enable_timer_wakeup((uint64_t)SLEEP_SECONDS * 1000000ULL);
    esp_deep_sleep_start();
  }

  // Ceder 2ms al planificador FreeRTOS
  delay(2);
}
