fedelt01hub/honda-civic-scanner/(commit log)

2026-10-31 feat: initial commit Honda Civic OBD scanner, firmware BLE y PWA web dashboard
    [manana.csv, tarde.csv, tarde2.csv]
2026-10-31 feat: implementar plan de mejora para sensor O2 secundario, diagnostico BLE y MIL OBD2
    - Decodificar sensor O2 secundario (byte 0x16) y registrar byte ADC crudo
    - Corregir deteccion de testigo MIL para ECU OBD2 P2P (bit 6 / bit 5 en 0x0B)
    - Sincronizar comando GET_DIAG en la cola de loop para evitar truncamiento por colision BLE
    - Corregir polling periodico en PWA (isConnected) y robustecer parser de fragmentos JSON
    - Agregar visor en tiempo real para sensor O2 secundario y actualizar cache a v21
    - Incluir plan_de_mejora_y_calibraci_n.md en el repositorio
2026-10-31 feat: optimizar diagnostico DTC, soporte fila 0x60, reconexion post-borrado y cola BLE
    - Eliminar bug de permutacion errónea en DTC 22/23
    - Añadir funcion isKnownDtc y filtro contra duplicados
    - Incorporar lectura activa de fila 0x60 (codigos > 63: catalizador 67, misfires 70-74, EVAP 90-92)
    - Prevenir timeout de desconexion en lecturas pesadas actualizando lastSuccessTime en readMemory
    - Mejorar borrado de códigos con pausa de reinicio de 800ms, reinit con sendInit y validacion de verifyOk
    - Implementar cola FIFO asincrona en PWA (sendBleCmd) para eliminar excepciones GATT en Web Bluetooth
    - Actualizar visor de memoria para DTC 0x60 y version de cache a v22
    - Incluir plan_mejora_codigos_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
    [honda-civic-scanner.ino, honda_kline.cpp, honda_kline.h]
2026-10-31 ui: mostrar version v22 en header, titulo y pestaña de diagnostico
2026-10-31 feat(pwa): icono de gatito oficial, soporte 100% offline y version v23
    [Civic99_Log_2026-10-30T19-55-30.csv, Civic99_Log_2026-10-31T20-56-55.csv, manana.csv, tarde.csv, tarde2.csv]
2026-11-02 feat: telemetria de 29 bytes con dos sensores O2 (S1 y S2), CSV y version v24
2026-11-02 feat(ui): boton manual para buscar actualizaciones y limpiar cache PWA
2026-11-02 fix(kline): delimitar fila 0x60 para eliminar falsos DTCs 72-91 y agregar soporte de Freeze Frame
    [honda-civic-scanner.ino, honda_kline.cpp, honda_kline.h]
2026-11-02 fix(firmware,pwa): 5 fixes de auditoria - v25 sync, FreezeFrame RPM/VSS, MIL real y timeout CSV
    [honda-civic-scanner.ino, honda_kline.cpp, honda_kline.h]
2026-11-03 feat(apk): empaquetado TWA auto-actualizable y PWA v26
    - manifest: id estable, iconos any/maskable separados, prefer_related_applications
    - sw.js: listener SKIP_WAITING; index.html no recarga si hay sesion BLE activa
    - twa/: twa-manifest, generador no interactivo (@bubblewrap/core) y build local
    - assetlinks.json para el repo fedelt01hub.github.io
    - workflow build-apk.yml que compila, firma y publica el APK en Releases
2026-11-03 docs: marcar assetlinks.json publicado en el plan APK
2026-11-03 feat(ui): pulido de interfaz v27 - legibilidad, semaforo de rangos y avisos sin alert()
    - Textos y testigos mas grandes y visibles para leer manejando
    - Colores por rango en ECT, bateria, IAT, knock, trims y RPM (solo con enlace ECU)
    - alert() reemplazados por toasts con tipo y modal informativo
    - Nav inferior con botones e iconos SVG; Diagnostico con seccion Avanzado
    - Fuente Chakra Petch local (offline) y precacheada en sw.js
2026-11-03 feat(ui): rediseno v28 estilo tablero OEM - relojes analogicos con aguja
    - Paleta negra con iluminacion ambar, sin glow neon; fuente Barlow Condensed local
    - Relojes RPM/velocidad/temperatura generados por JS (buildGauge) con aguja,
    zona roja y barrido de agujas al conectar
    - Sensores en paneles tipo computadora de viaje; testigos estilo lampara
    - Datalogger, Diagnostico y modales con el mismo lenguaje visual
2026-11-03 docs: eliminar documentos de planes completados
2026-11-03 build: flash.sh usa el pio instalado y entorno native para tests
2026-11-03 feat(fw): nombre BLE unico, comando INFO y deep sleep sin ECU ni celular
    - telemetry_frame.h: trama BLE de 29 bytes con test dorado
    - device_info.h: nombre Civic99-OBD-XXXX (MAC) y respuesta INFO
    - power_policy.h: deep sleep 15 s / ventana 3 s con llave en OFF
2026-11-03 feat(app): v29 - buscar escaneres por prefijo de nombre Civic99-OBD
2026-11-03 feat(app): v30 - mostrar equipo/FW/HW (INFO) en Avanzado y corregir etiqueta de version
2026-11-03 docs: manual de cliente K-Lino (Android, iPhone con Bluefy y solucion de problemas)
2026-11-04 feat(fw): 1.2.0 - lectura/borrado de DTC confiables
    - honda_frame.h: tramas Honda (checksum, peticion, validacion 00 LEN+3, ACK de borrado) con tests
    - honda_dtc.h: tabla, decodificacion de nibbles 0x40-0x5F y 0x60, regla de seguridad y JSON de borrado con tests
    - GET_DTC: verifica ECU y MIL fresco antes de leer; no reutiliza Freeze Frame viejo
    - CLEAR_DTC: rechaza con motor encendido/en movimiento, reintenta reconexion y verifica releyendo memoria (cleared/error)
    - bleSendText respeta el MTU del celular; demo muestra codigo 14 correcto
    [device_info.h, honda-civic-scanner.ino, honda_dtc.h, honda_frame.h, honda_kline.cpp, honda_kline.h]
2026-11-04 feat(app): v1.0 - timeouts de DTC, mensajes de borrado seguro/verificado y buffer JSON 16 KB
    Reinicia la numeracion de la app (v31 -> v1.0); el chequeo de actualizacion compara por desigualdad.
2026-11-04 feat(app): v1.1 - animacion de arranque 'chequeo de tablero' con letras K-LINO; etiqueta K-LINE
2026-11-04 feat(app): v1.2 - splash de tacometro analogico que revoluciona con sonido VTEC sincronizado
    Sonido: 'Car Revving (Engine and Exhaust Mix)' de EvanBoyerman (Freesound, CC BY 4.0), recortado.
    Interruptor y credito en Avanzado.
2026-11-04 feat(app): v1.3 - pantalla de arranque de Android muestra el tacometro (gatito queda como icono del lanzador)
    manifest: gatito = maskable (lanzador), tacometro en reposo = any (splash de Chrome).
    TWA: iconUrl = tacometro (splash), maskableIconUrl = gatito; fondo #050506.
2026-11-04 feat(android): v1.4 - APK nativo con Capacitor, Bluetooth nativo y actualizaciones en vivo
2026-11-04 fix(ci): setup-android con paquetes explicitos (el paquete 'tools' ya no existe)
2026-11-05 feat(hardware): PCB KiCad del escaner (ESP32-C3 + L9637D), carcasa 3D y archivos JLCPCB
    - Esquematico y PCB 66x42 mm 2 capas generados por scripts (hardware/scripts)
    - Buck AP63205 12V->5V, LDO 3.3V, USB-C con ESD, protecciones de entrada
    - Cable adaptador Honda 3p->OBD2 soldado a J1; 3 LEDs junto al USB-C
    - ERC 0 / DRC 0; Gerbers, BOM y CPL para JLCPCB en hardware/fab
    - Carcasa imprimible (base + tapa STL) y ensamble FreeCAD
    [case_assembly.stl, case_base.stl, case_base_asm.stl, case_lid.stl, case_lid_asm.stl, case_preview_exploded.stl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]
2026-11-10 fix(app): v1.5 - APK espera hasta 1.5 s el audio del splash (antes se pausaba si tardaba >400 ms)
